beiye66/container-monitor/container-monitor-fw/Core/Src/main.c

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
/* Includes ------------------------------------------------------------------*/
#include "main.h"
#include "i2c.h"
#include "tim.h"
#include "usart.h"
#include "gpio.h"

/* USER CODE BEGIN Includes */
#include <stdio.h>
#include <string.h>
#include "mpu6050.h"
#include "bme680_hal.h"
/* USER CODE END Includes */


/* USER CODE BEGIN PV */
static uint32_t imu_seq = 0;
static uint32_t env_seq = 0;
static uint32_t tick_count = 0;
static uint8_t  bme680_ready = 0;
volatile uint8_t imu_flag = 0;   /* 由 TIM2 中断置 1，主循环清零 */
#define ENV_TICKS 45000U   /* 50 Hz * 60 s * 15 min */
/* USER CODE END PV */

void SystemClock_Config(void);
/**
  * @brief  The application entry point.
  * @retval int
  */
int main(void)
{

  /* MCU Configuration--------------------------------------------------------*/

  /* Reset of all peripherals, Initializes the Flash interface and the Systick. */
  HAL_Init();

  /* Configure the system clock */
  SystemClock_Config();

  /* Initialize all configured peripherals */
  MX_GPIO_Init();
  MX_I2C1_Init();
  MX_TIM2_Init();
  MX_USART1_UART_Init();
  /* USER CODE BEGIN 2 */
  HAL_Delay(300);
  const char *banner = "# container-monitor v0.1\r\n";
  HAL_UART_Transmit(&huart1, (uint8_t *)banner, strlen(banner), 100);
  if (MPU6050_Init() != HAL_OK) {
    const char *err = "# MPU6050 init FAILED\r\n";
    HAL_UART_Transmit(&huart1, (uint8_t *)err, strlen(err), 100);
    Error_Handler();
  }
  if (BME680_Init() == HAL_OK) {
    bme680_ready = 1;
  } else {
    const char *warn = "# BME680 init FAILED, env disabled\r\n";
    HAL_UART_Transmit(&huart1, (uint8_t *)warn, strlen(warn), 100);
  }
  HAL_TIM_Base_Start_IT(&htim2);  /* 启动 TIM2，50Hz 中断开始触发 */
  /* USER CODE END 2 */

  /* Infinite loop */
  /* USER CODE BEGIN WHILE */
  while (1)
  {
    /* USER CODE END WHILE */

    /* USER CODE BEGIN 3 */
    if (imu_flag) {
      imu_flag = 0;

      int16_t ax, ay, az, gx, gy, gz;
      if (MPU6050_Read(&ax, &ay, &az, &gx, &gy, &gz) != HAL_OK) continue;

      char buf[64];
      int len = snprintf(buf, sizeof(buf), "I,%u,%u,%d,%d,%d,%d,%d,%d\r\n",
                         (unsigned)imu_seq++, (unsigned)HAL_GetTick(),
                         ax, ay, az, gx, gy, gz);
      HAL_UART_Transmit(&huart1, (uint8_t *)buf, (uint16_t)len, 20);

      if (++tick_count >= ENV_TICKS) {
        tick_count = 0;
        if (bme680_ready) {
          BME680_Result env;
          if (BME680_ReadForced(&env) == HAL_OK) {
            char ebuf[80];
            int elen = snprintf(ebuf, sizeof(ebuf),
                                "E,%u,%u,%.2f,%.2f,%.2f,%u\r\n",
                                (unsigned)env_seq++, (unsigned)HAL_GetTick(),
                                (double)env.temperature,
                                (double)env.humidity,
                                (double)env.pressure,
                                (unsigned)env.gas_resistance);
            HAL_UART_Transmit(&huart1, (uint8_t *)ebuf, (uint16_t)elen, 50);
          }
        }
      }
    }
  }
  /* USER CODE END 3 */
}

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
