beiye66/container-monitor/(commit log)

2026-05-01 init: 面向集装箱状态监控的异构数据采集与边缘融合平台
    - STM32F103C8 + MPU6050(±8g) + BME680 双传感器固件
    - TIM2 硬件定时中断驱动 50Hz IMU 采集
    - Bosch bme68x API 集成，BME680 Forced Mode 环境采样
    - 行式 ASCII 串口协议，Python collector.py 实时落 CSV
2026-05-01 docs: 将 Blue Pill 替换为 STM32F1
2026-05-01 docs: 更新串口数据展示图
