beiye66/container-monitor/container-monitor-fw/docs/images/hardware.jpg

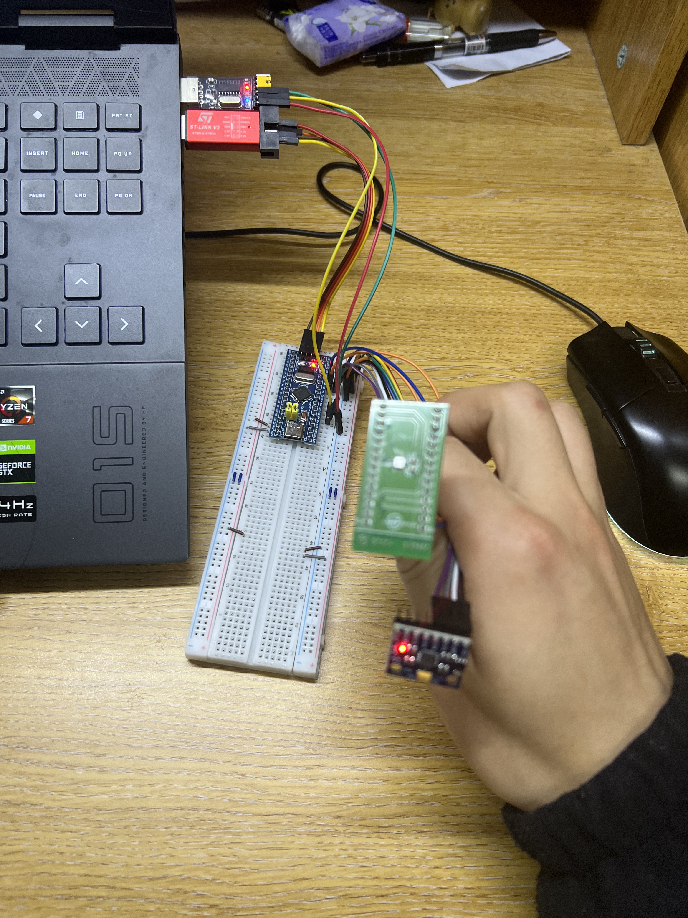
[picture p1: container-monitor-fw/docs/images/hardware.jpg]
container-monitor-fw/docs/images/hardware.jpg
